OBauck/BESC/stspin32f0_rev_0_9.brd

## EAGLE design stspin32f0_rev_0_9.brd (2017-07-14)

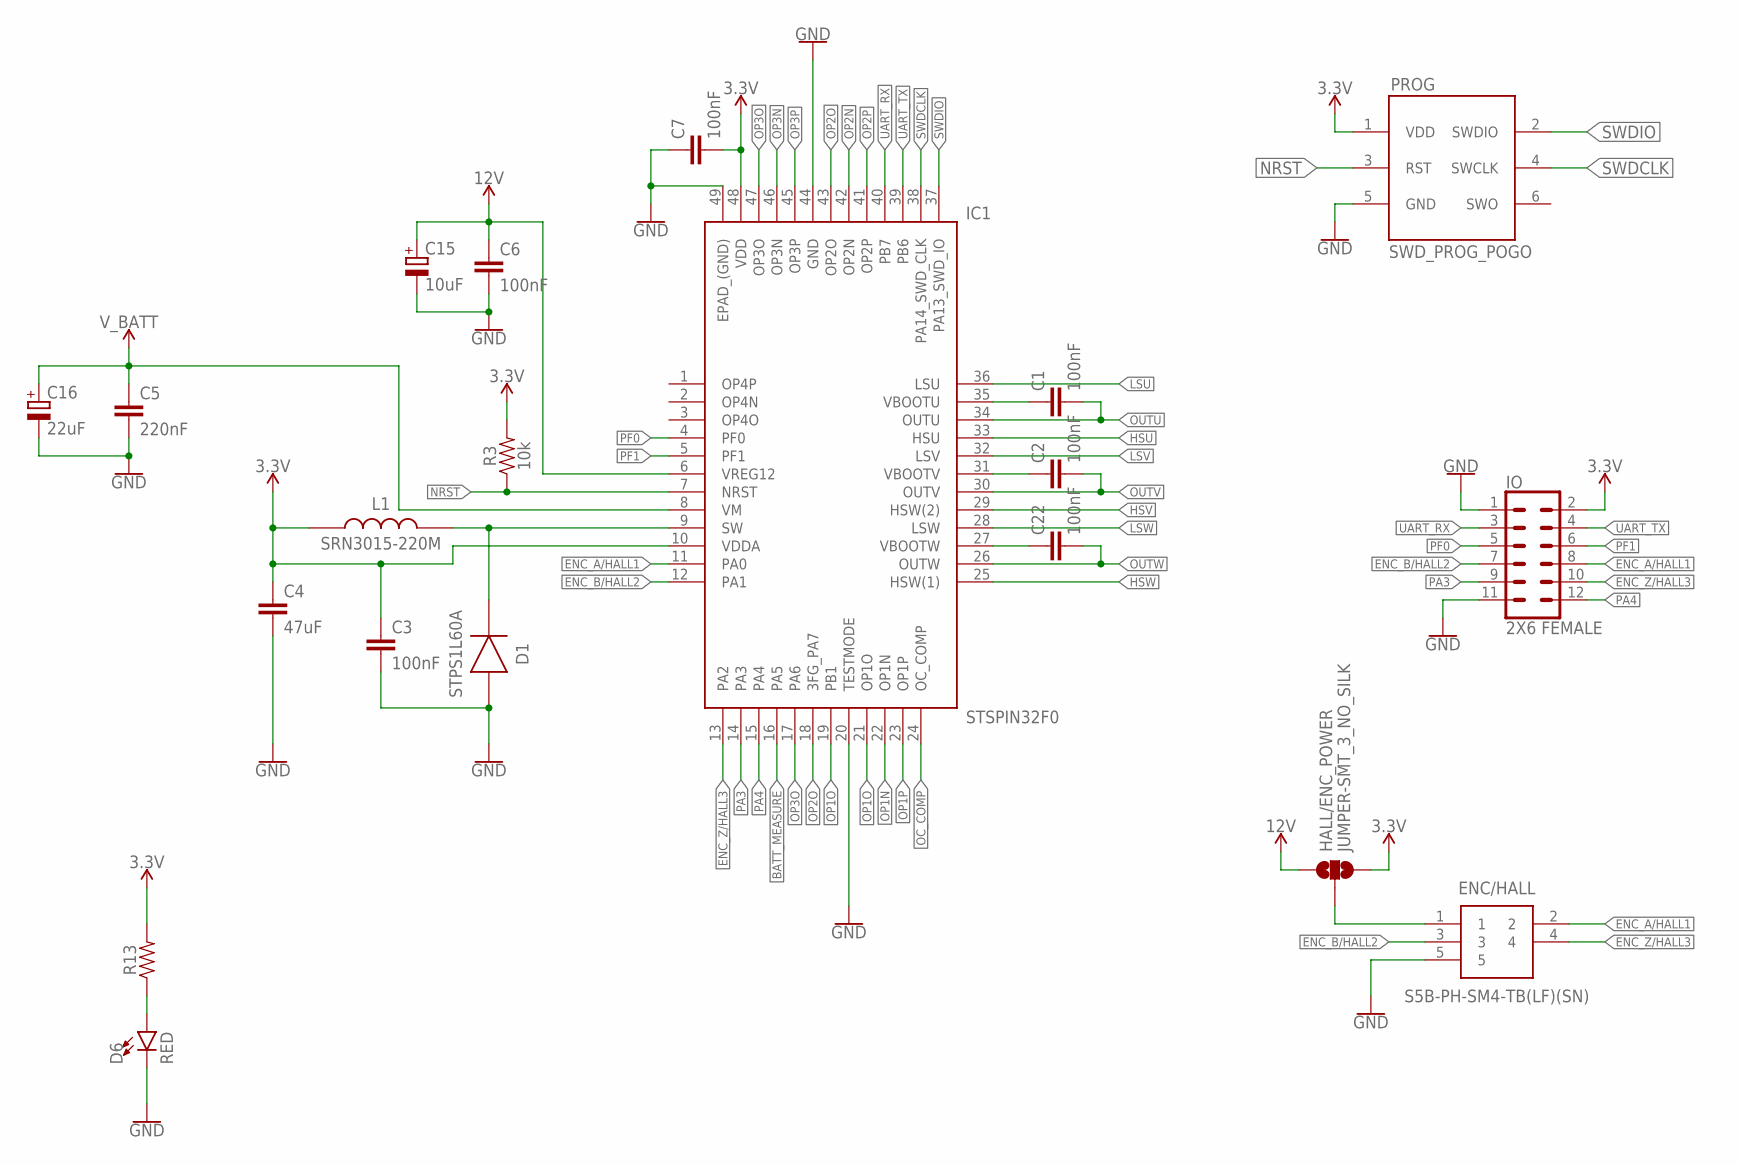
[picture p1: schematic stspin32f0_rev_0_9.sch, sheet 1]

Parts:
C1, C2, C3, C6, C7, C22: 100nF; 0603
C4: 47uF; 0805
C5: 220nF; 0805
C15: 10uF; UD-5X5,8_NICHICON
C16: 22uF; UD-6,3X5,8_NICHICON
D1: STPS1L60A; DIOM5126X265N
D6: RED; LED-0603
ENC/HALL: S5B-PH-SM4-TB(LF)(SN); S5B-PH-SM4-TB_1
HALL/ENC_POWER: JUMPER-SMT_3_NO_SILK; SMT-JUMPER_3_NO_SILK
IC1: STSPIN32F0; QFN50P700X700X100-49N
IO: 2X6 FEMALE; 2X6
L1: SRN3015-220M; SRN3015
PROG: SWD_PROG_POGO; 1X06_1.27MM
R3: 10k; 0603
R13: RES-1/10W-5%-0603; 0603

Connections:
3.3V: C3.1, C4.1, C7.2, HALL/ENC_POWER.3, IC1.10 (VDDA), IC1.48 (VDD), IO.2, L1.1, PROG.1 (VDD), R3.2, R13.2; also elsewhere on the board
12V: C6.1, C15.+, HALL/ENC_POWER.1, IC1.6 (VREG12)
BATT_MEASURE: IC1.16 (PA5); also elsewhere on the board
ENC_A/HALL1: ENC/HALL.2, IC1.11 (PA0), IO.8
ENC_B/HALL2: ENC/HALL.3, IC1.12 (PA1), IO.7
ENC_Z/HALL3: ENC/HALL.4, IC1.13 (PA2), IO.10
GND: C3.2, C4.2, C5.2, C6.2, C7.1, C15.-, C16.-, D1.2 (A), D6.C, ENC/HALL.5, IC1.20 (TESTMODE), IC1.44 (GND), IC1.49 (EPAD_(GND)), IO.1, IO.11, PROG.5 (GND); also elsewhere on the board
HSU: IC1.33 (HSU); also elsewhere on the board
HSV: IC1.29 (HSW(2)); also elsewhere on the board
HSW: IC1.25 (HSW(1)); also elsewhere on the board
LSU: IC1.36 (LSU); also elsewhere on the board
LSV: IC1.32 (LSV); also elsewhere on the board
LSW: IC1.28 (LSW); also elsewhere on the board
unnamed: C1.1, IC1.35 (VBOOTU)
unnamed: D1.1 (K), IC1.9 (SW), L1.2
unnamed: D6.A, R13.1
unnamed: C2.1, IC1.31 (VBOOTV)
unnamed: C22.1, IC1.27 (VBOOTW)
unnamed: ENC/HALL.1, HALL/ENC_POWER.2
NRST: IC1.7 (NRST), PROG.3 (RST), R3.1
OC_COMP: IC1.24 (OC_COMP); also elsewhere on the board
OP1N: IC1.22 (OP1N); also elsewhere on the board
OP1O: IC1.19 (PB1), IC1.21 (OP1O); also elsewhere on the board
OP1P: IC1.23 (OP1P); also elsewhere on the board
OP2N: IC1.42 (OP2N); also elsewhere on the board
OP2O: IC1.18 (3FG_PA7), IC1.43 (OP2O); also elsewhere on the board
OP2P: IC1.41 (OP2P); also elsewhere on the board
OP3N: IC1.46 (OP3N); also elsewhere on the board
OP3O: IC1.17 (PA6), IC1.47 (OP3O); also elsewhere on the board
OP3P: IC1.45 (OP3P); also elsewhere on the board
OUTU: C1.2, IC1.34 (OUTU); also elsewhere on the board
OUTV: C2.2, IC1.30 (OUTV); also elsewhere on the board
OUTW: C22.2, IC1.26 (OUTW); also elsewhere on the board
PA3: IC1.14 (PA3), IO.9
PA4: IC1.15 (PA4), IO.12
PF0: IC1.4 (PF0), IO.5
PF1: IC1.5 (PF1), IO.6
SWDCLK: IC1.38 (PA14_SWD_CLK), PROG.4 (SWCLK)
SWDIO: IC1.37 (PA13_SWD_IO), PROG.2 (SWDIO)
UART_RX: IC1.40 (PB7), IO.3
UART_TX: IC1.39 (PB6), IO.4
V_BATT: C5.1, C16.+, IC1.8 (VM); also elsewhere on the board

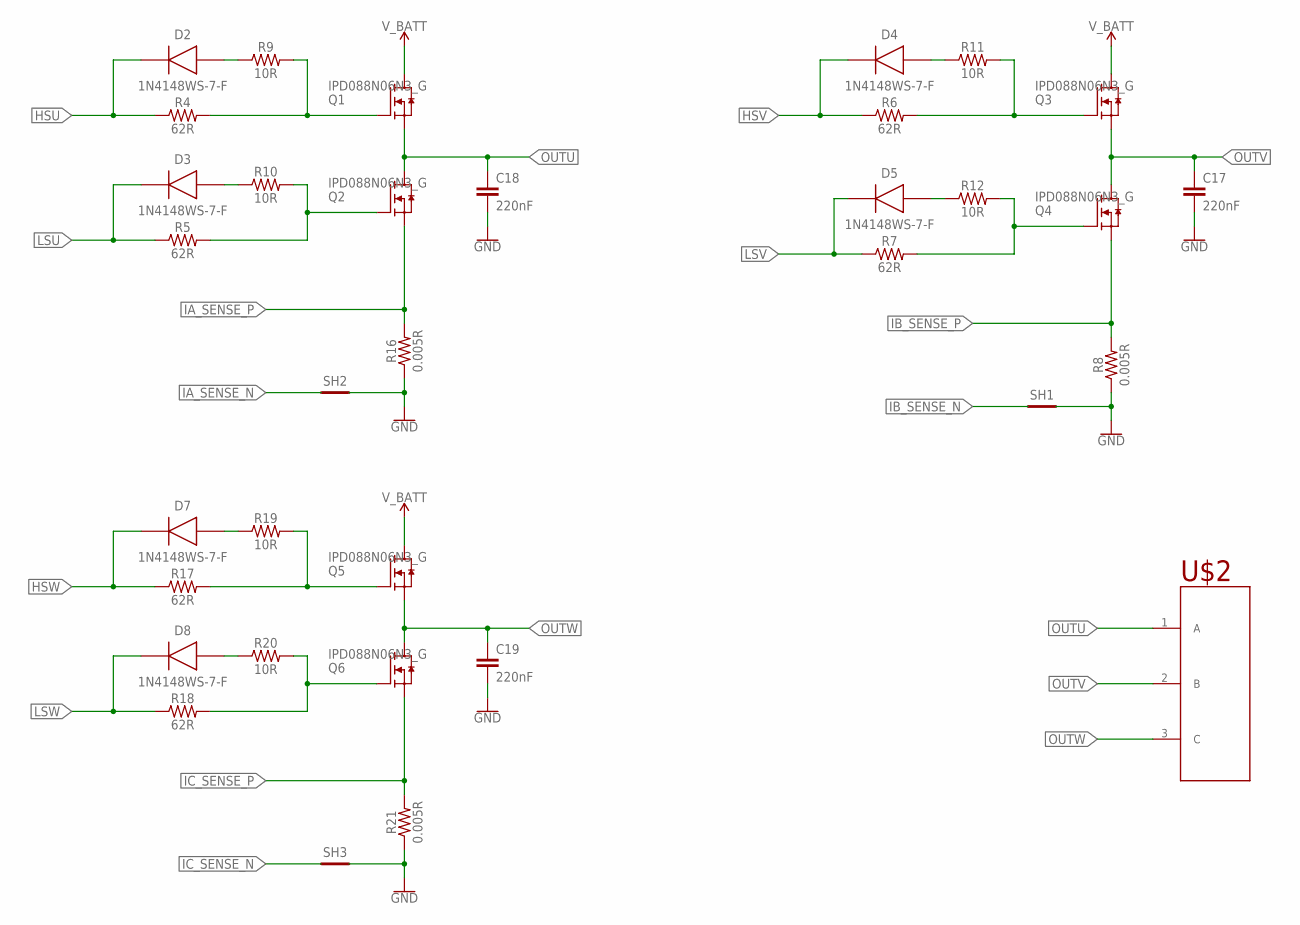
[picture p2: schematic stspin32f0_rev_0_9.sch, sheet 2]

Parts:
C17, C18, C19: 220nF; 0805
D2, D3, D4, D5, D7, D8: 1N4148WS-7-F; SOD2513X120N
Q1, Q2, Q3, Q4, Q5, Q6: IPD088N06N3_G; DPAK(TO-252-3)
R4, R5, R6, R7, R17, R18: 62R; 0603
R8, R16, R21: 0.005R; R2512
R9, R10, R11, R12, R19, R20: 10R; 0603
SH1, SH2, SH3: SHORTT5; SHORT_TOP-50
U$2: MR30; MR30PW

Connections:
GND: C17.2, C18.2, C19.2, R8.1, R16.1, R21.1, SH1.2, SH2.2, SH3.2; also elsewhere on the board
HSU: D2.1 (K), R4.1; also elsewhere on the board
HSV: D4.1 (K), R6.1; also elsewhere on the board
HSW: D7.1 (K), R17.1; also elsewhere on the board
IA_SENSE_N: SH2.1; also elsewhere on the board
IA_SENSE_P: Q2.3 (S), R16.2; also elsewhere on the board
IB_SENSE_N: SH1.1; also elsewhere on the board
IB_SENSE_P: Q4.3 (S), R8.2; also elsewhere on the board
IC_SENSE_N: SH3.1; also elsewhere on the board
IC_SENSE_P: Q6.3 (S), R21.2; also elsewhere on the board
LSU: D3.1 (K), R5.1; also elsewhere on the board
LSV: D5.1 (K), R7.1; also elsewhere on the board
LSW: D8.1 (K), R18.1; also elsewhere on the board
unnamed: D7.2 (A), R19.1
unnamed: D8.2 (A), R20.1
unnamed: D4.2 (A), R11.1
unnamed: D2.2 (A), R9.1
unnamed: D3.2 (A), R10.1
unnamed: Q6.1 (G), R18.2, R20.2
unnamed: D5.2 (A), R12.1
unnamed: Q5.1 (G), R17.2, R19.2
unnamed: Q4.1 (G), R7.2, R12.2
unnamed: Q3.1 (G), R6.2, R11.2
unnamed: Q2.1 (G), R5.2, R10.2
unnamed: Q1.1 (G), R4.2, R9.2
OUTU: C18.1, Q1.3 (S), Q2.2 (D), U$2.1 (A); also elsewhere on the board
OUTV: C17.1, Q3.3 (S), Q4.2 (D), U$2.2 (B); also elsewhere on the board
OUTW: C19.1, Q5.3 (S), Q6.2 (D), U$2.3 (C); also elsewhere on the board
V_BATT: Q1.2 (D), Q3.2 (D), Q5.2 (D); also elsewhere on the board

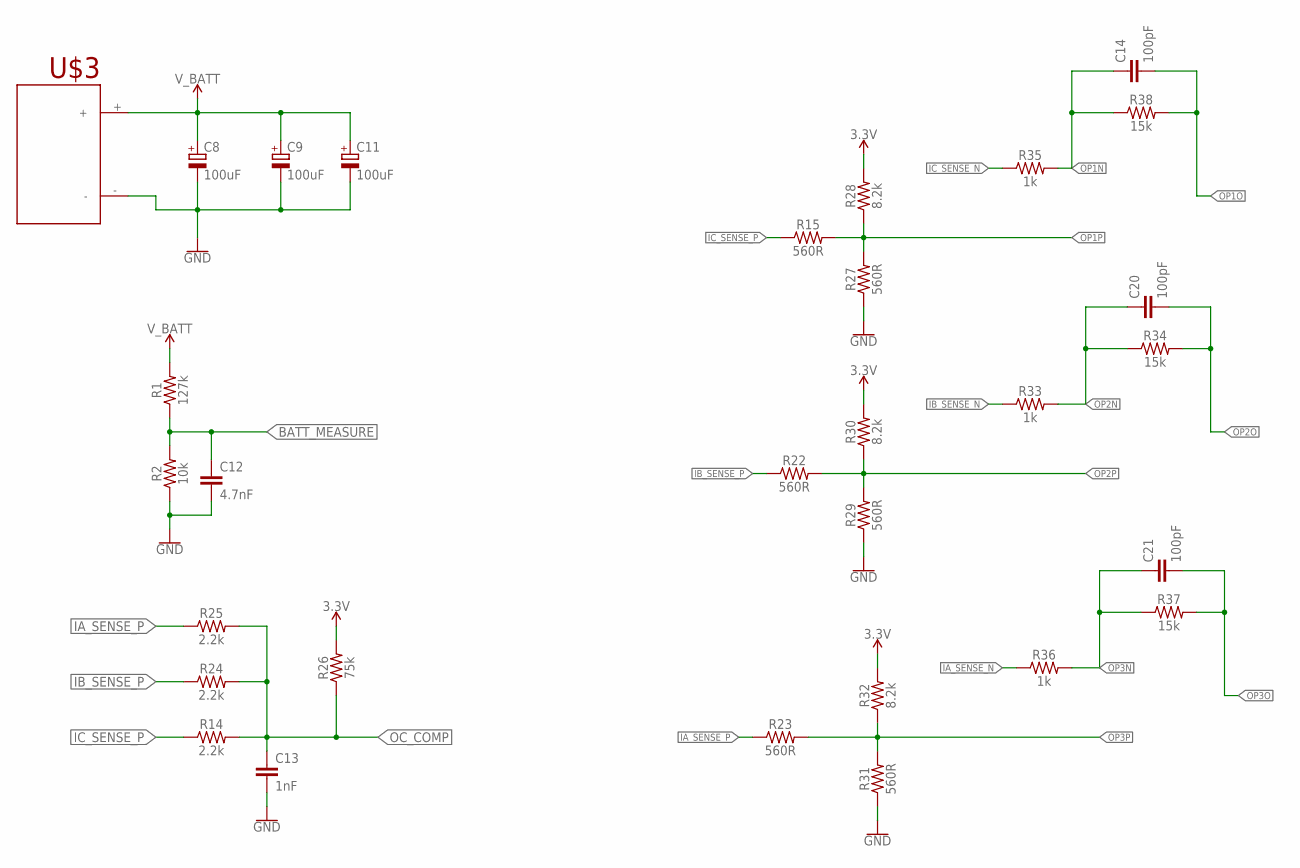
[picture p3: schematic stspin32f0_rev_0_9.sch, sheet 3]

Parts:
C8, C9, C11: 100uF; UD-6,3X7,7_NICHICON
C12: 4.7nF; 0603
C13: 1nF; 0603
C14, C20, C21: 100pF; 0603
R1: 127k; 0603
R2: 10k; 0603
R14, R24, R25: 2.2k; 0603
R15, R22, R23, R27, R29, R31: 560R; 0603
R26: 75k; 0603
R28, R30, R32: 8.2k; 0603
R33, R35, R36: 1k; 0603
R34, R37, R38: 15k; 0603
U$3: XT30; XT30PW

Connections:
3.3V: R26.2, R28.2, R30.2, R32.2; also elsewhere on the board
BATT_MEASURE: C12.1, R1.1, R2.2; also elsewhere on the board
GND: C8.-, C9.-, C11.-, C12.2, C13.2, R2.1, R27.1, R29.1, R31.1, U$3.-; also elsewhere on the board
IA_SENSE_N: R36.1; also elsewhere on the board
IA_SENSE_P: R23.1, R25.1; also elsewhere on the board
IB_SENSE_N: R33.1; also elsewhere on the board
IB_SENSE_P: R22.1, R24.1; also elsewhere on the board
IC_SENSE_N: R35.1; also elsewhere on the board
IC_SENSE_P: R14.1, R15.1; also elsewhere on the board
OC_COMP: C13.1, R14.2, R24.2, R25.2, R26.1; also elsewhere on the board
OP1N: C14.1, R35.2, R38.1; also elsewhere on the board
OP1O: C14.2, R38.2; also elsewhere on the board
OP1P: R15.2, R27.2, R28.1; also elsewhere on the board
OP2N: C20.1, R33.2, R34.1; also elsewhere on the board
OP2O: C20.2, R34.2; also elsewhere on the board
OP2P: R22.2, R29.2, R30.1; also elsewhere on the board
OP3N: C21.1, R36.2, R37.1; also elsewhere on the board
OP3O: C21.2, R37.2; also elsewhere on the board
OP3P: R23.2, R31.2, R32.1; also elsewhere on the board
V_BATT: C8.+, C9.+, C11.+, R1.2, U$3.+; also elsewhere on the board

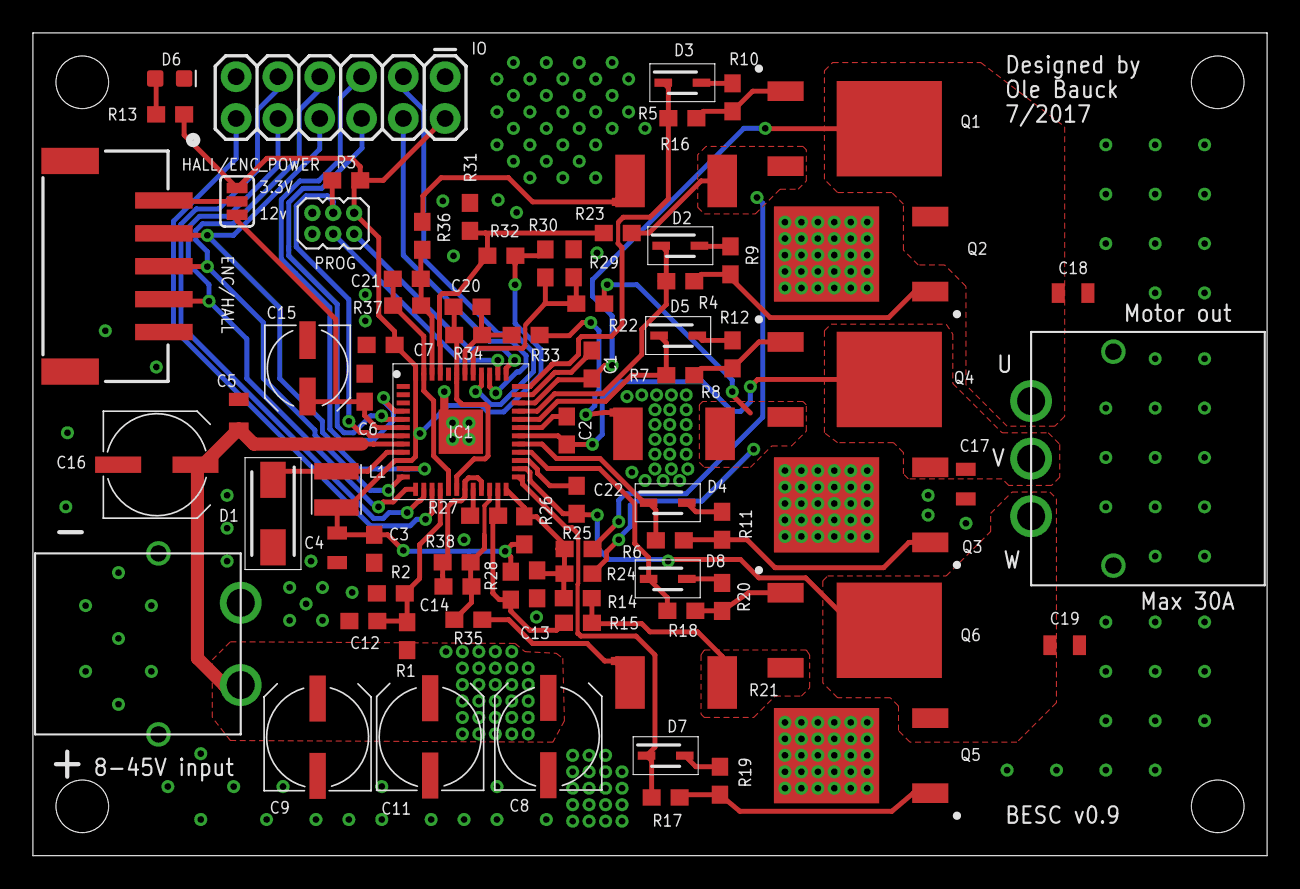
[picture p4: board stspin32f0_rev_0_9.brd from above]

Board: 2 copper layers, 75.0 x 50.0 mm, 84 parts (0 on the bottom side), 60 nets.
