OBauck/BESC/(commit log)

2017-07-10 first commit, board almost routed
    [stspin32f0_rev_0_9.brd, stspin32f0_rev_0_9.sch]
2017-07-10 routing done and drc cleared
    [stspin32f0_rev_0_9.brd, stspin32f0_rev_0_9.sch]
2017-07-10 added gerber files
    [stspin32f0_rev_0_9.GBL, stspin32f0_rev_0_9.GBO, stspin32f0_rev_0_9.GBP, stspin32f0_rev_0_9.GBS, stspin32f0_rev_0_9.GTL, stspin32f0_rev_0_9.GTO, stspin32f0_rev_0_9.GTP, stspin32f0_rev_0_9.GTS]
2017-07-10 minor fixes
    [stspin32f0_rev_0_9.brd]
2017-07-10 fixed names
    [stspin32f0_rev_0_9.brd, stspin32f0_rev_0_9.sch]
2017-07-14 More vias and wider tracks for more current
    [stspin32f0_rev_0_9.brd, stspin32f0_rev_0_9.sch]
2017-07-15 gerbers for first revision ordered
    [stspin32f0_rev_0_9.GBL, stspin32f0_rev_0_9.GKO, stspin32f0_rev_0_9.GTL, stspin32f0_rev_0_9.GTO, stspin32f0_rev_0_9.GTP, stspin32f0_rev_0_9.GTS]
